Jack-of-all-trades-04/peruri-sentinel-chip/diagrams/diagram_1_arsitektur_sistem.png

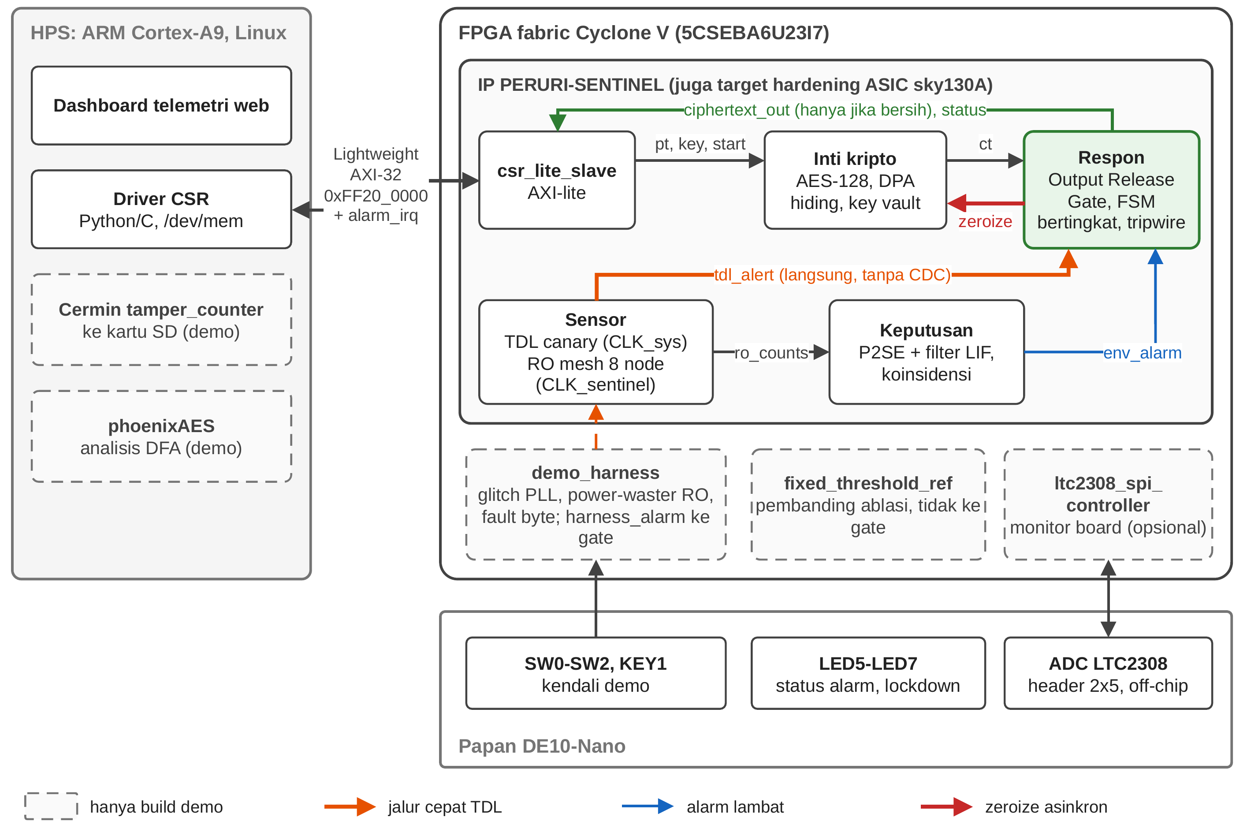
diagrams/diagram_1_arsitektur_sistem.png
