Jack-of-all-trades-04/peruri-sentinel-chip/diagrams/diagram_2_datapath_clock_domain.png

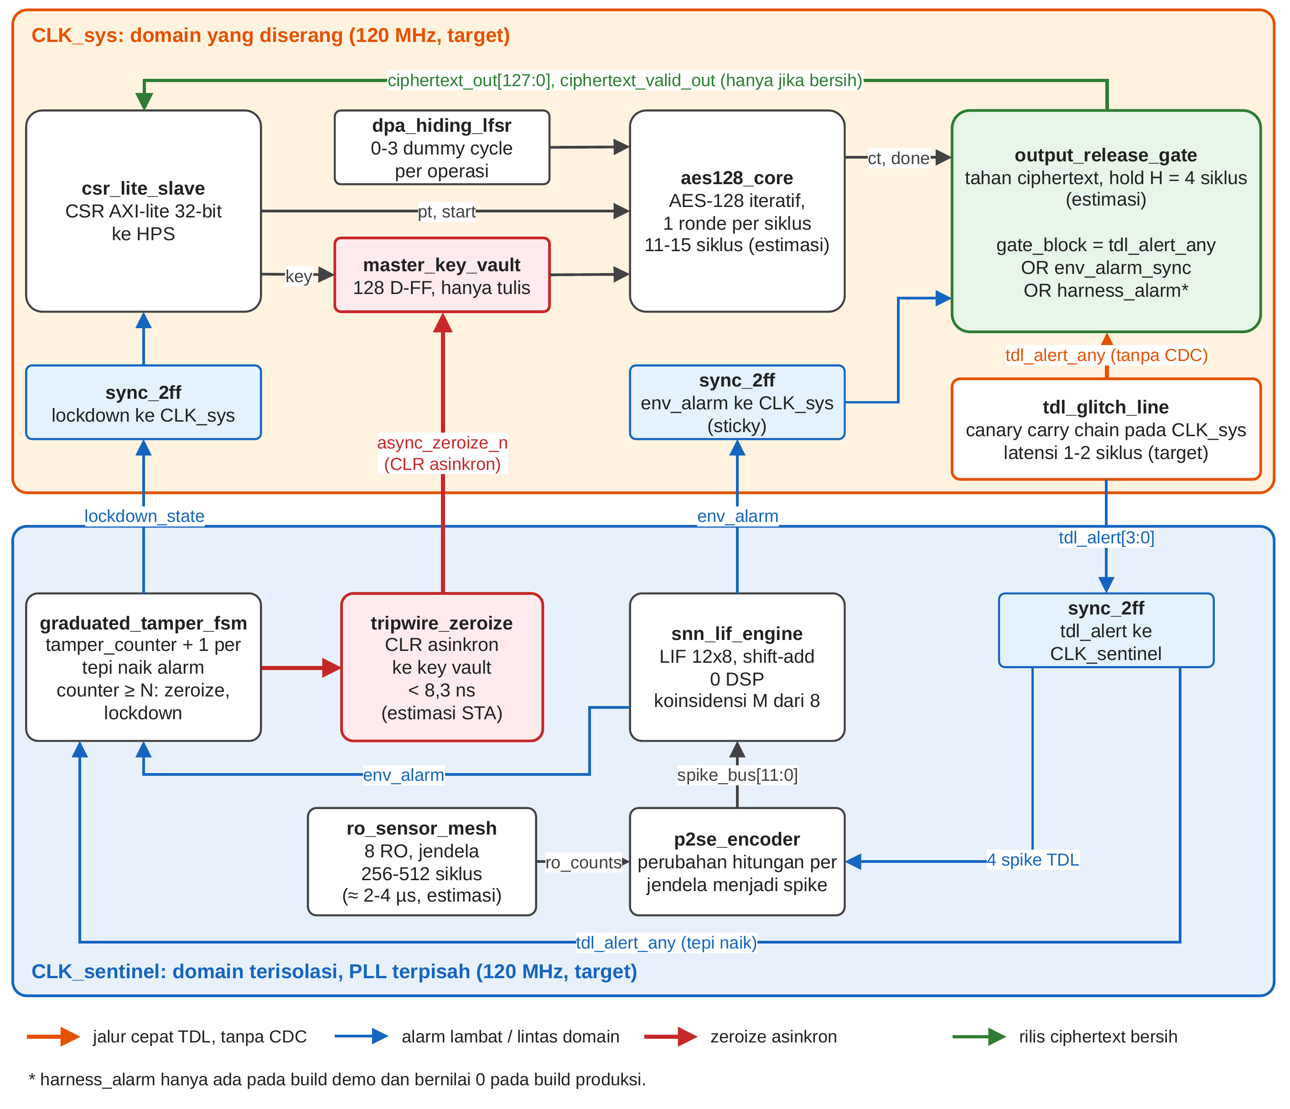
diagrams/diagram_2_datapath_clock_domain.png
