Jack-of-all-trades-04/peruri-sentinel-chip/diagrams/diagram_3_fsm_respon_bertingkat.png

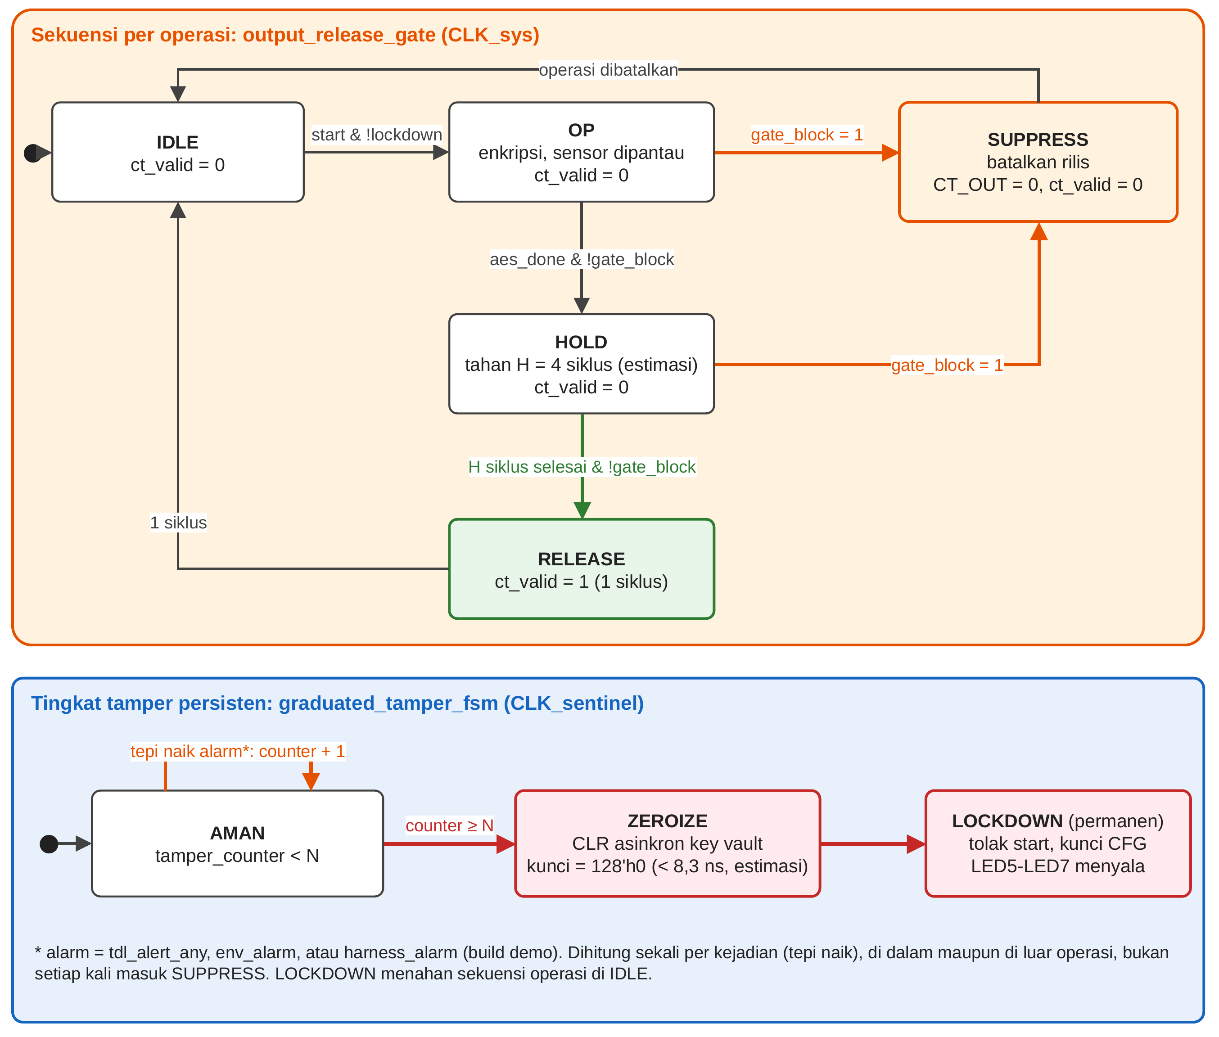
diagrams/diagram_3_fsm_respon_bertingkat.png
