Jack-of-all-trades-04/peruri-sentinel-chip/diagrams/diagram_4_timing_output_release_gate.png

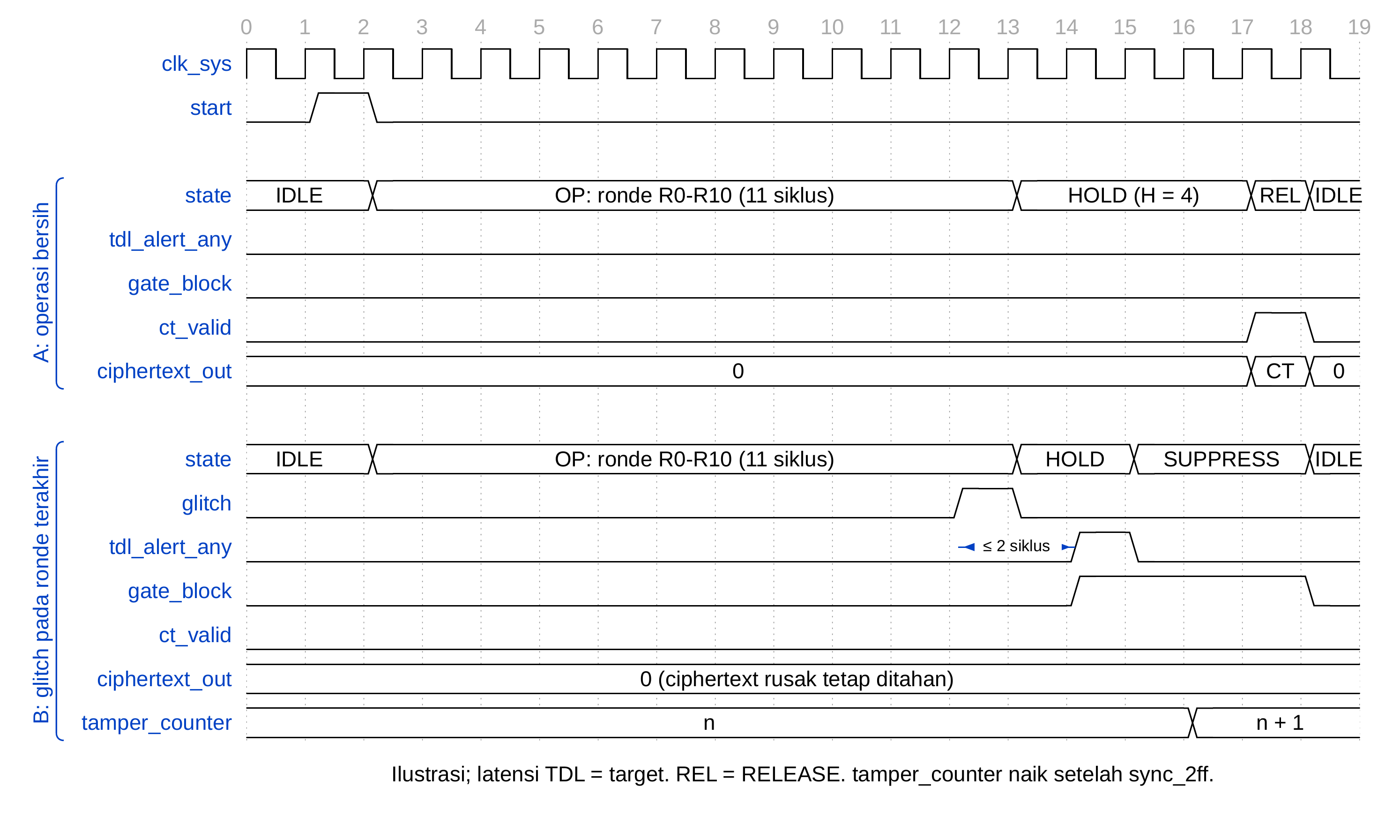
diagrams/diagram_4_timing_output_release_gate.png
