Jack-of-all-trades-04/peruri-sentinel-chip/diagrams/waveforms/T1_02_sentinel_off_ciphertext_salah_bocor.png

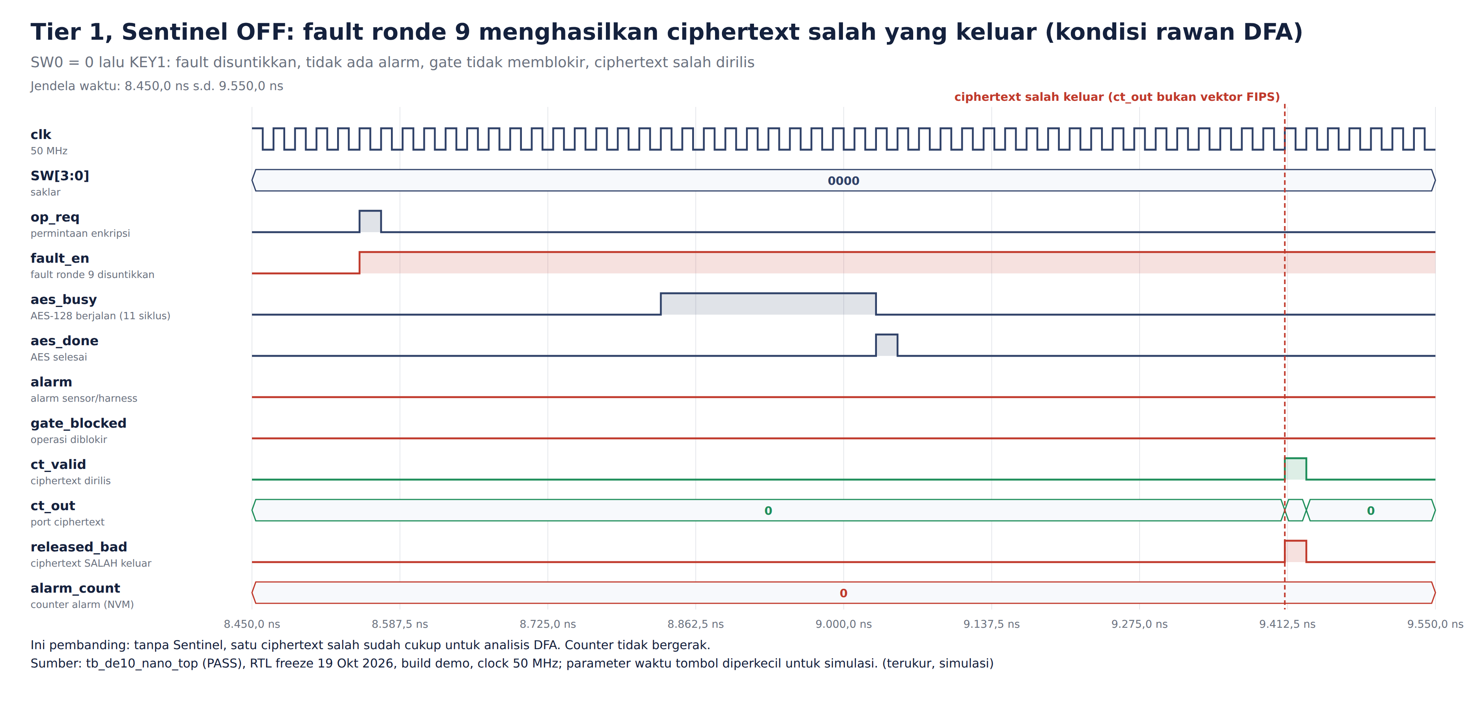
diagrams/waveforms/T1_02_sentinel_off_ciphertext_salah_bocor.png
