Jack-of-all-trades-04/peruri-sentinel-chip/diagrams/waveforms/T1_03_sentinel_on_serangan_diblokir.png

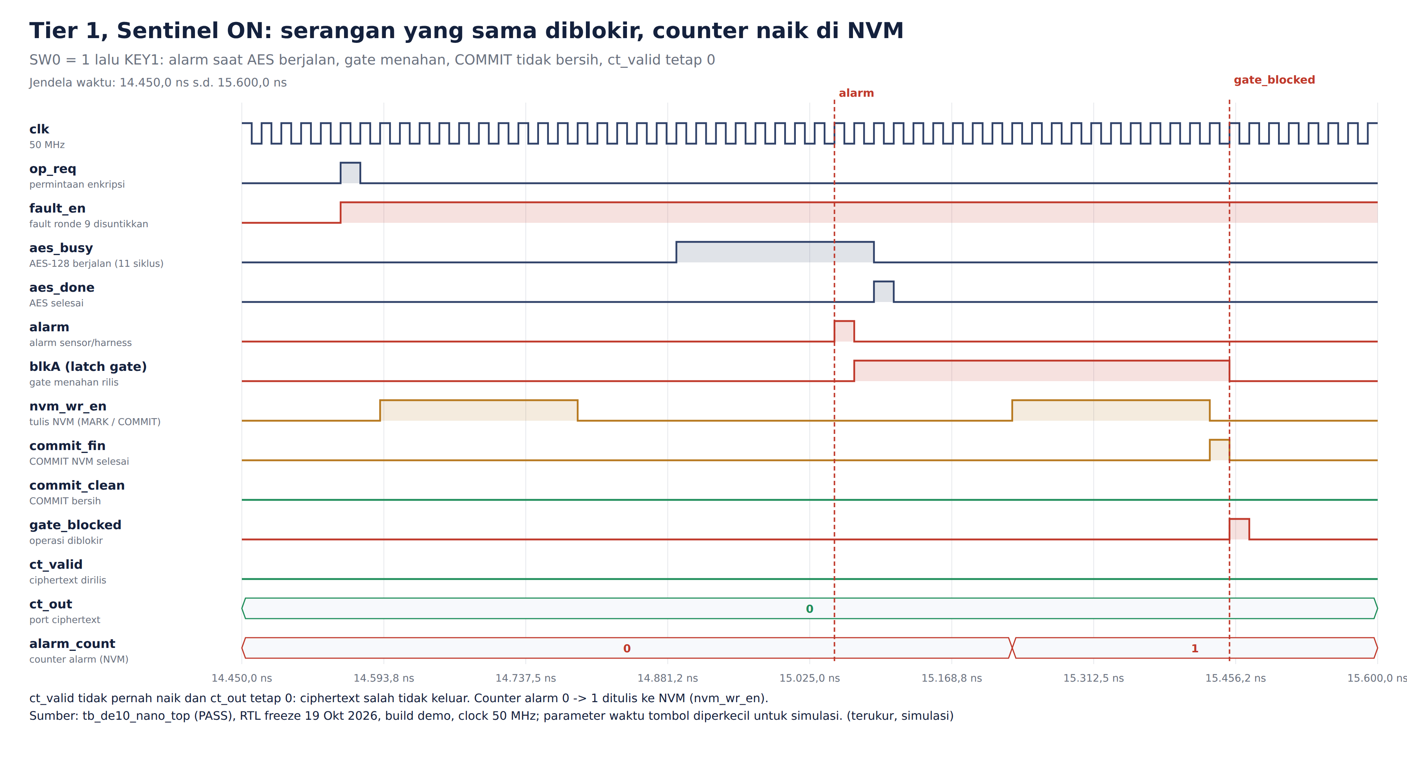
diagrams/waveforms/T1_03_sentinel_on_serangan_diblokir.png
