Jack-of-all-trades-04/peruri-sentinel-chip/diagrams/waveforms/T1_04_serangan_ke4_lockdown_zeroize.png

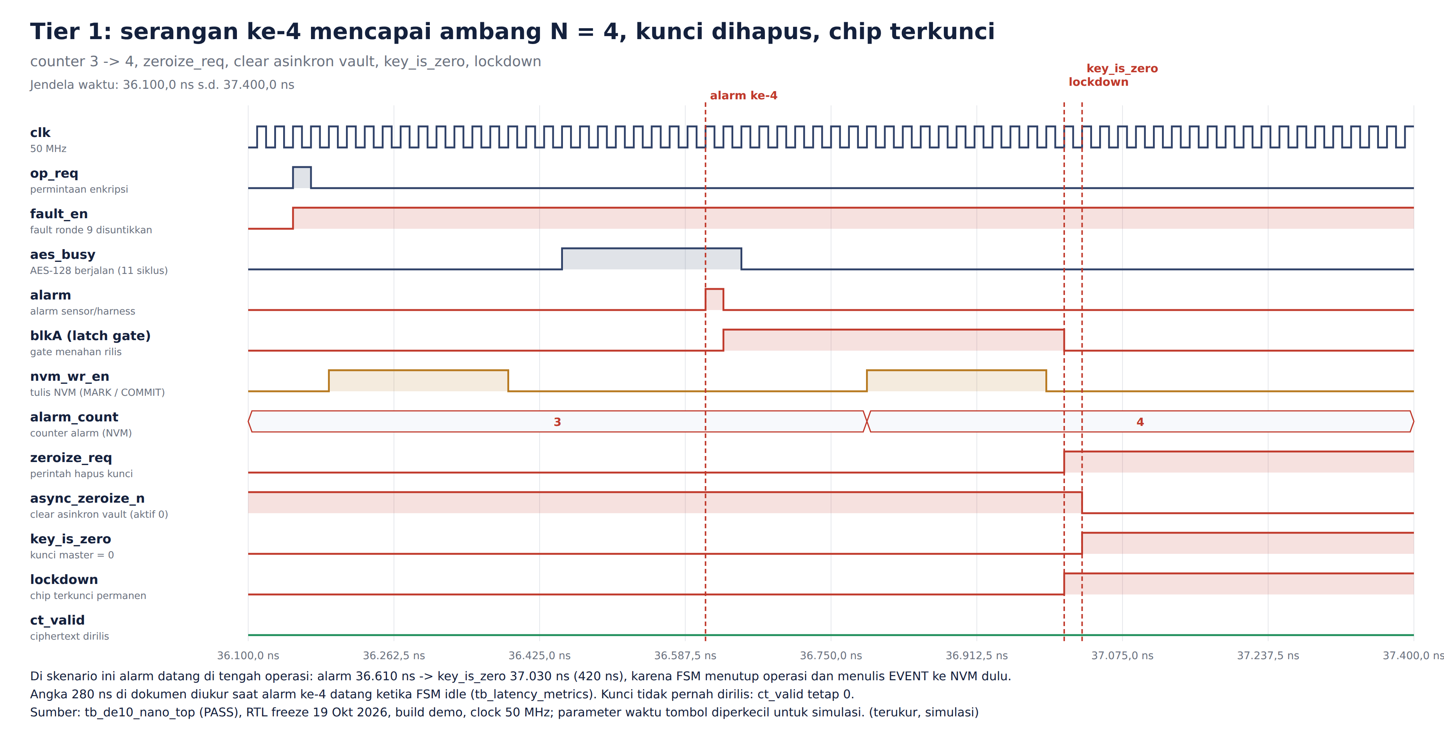
diagrams/waveforms/T1_04_serangan_ke4_lockdown_zeroize.png
