Jack-of-all-trades-04/peruri-sentinel-chip/diagrams/waveforms/T1_06_kartu_dicabut_counter_bertahan.png

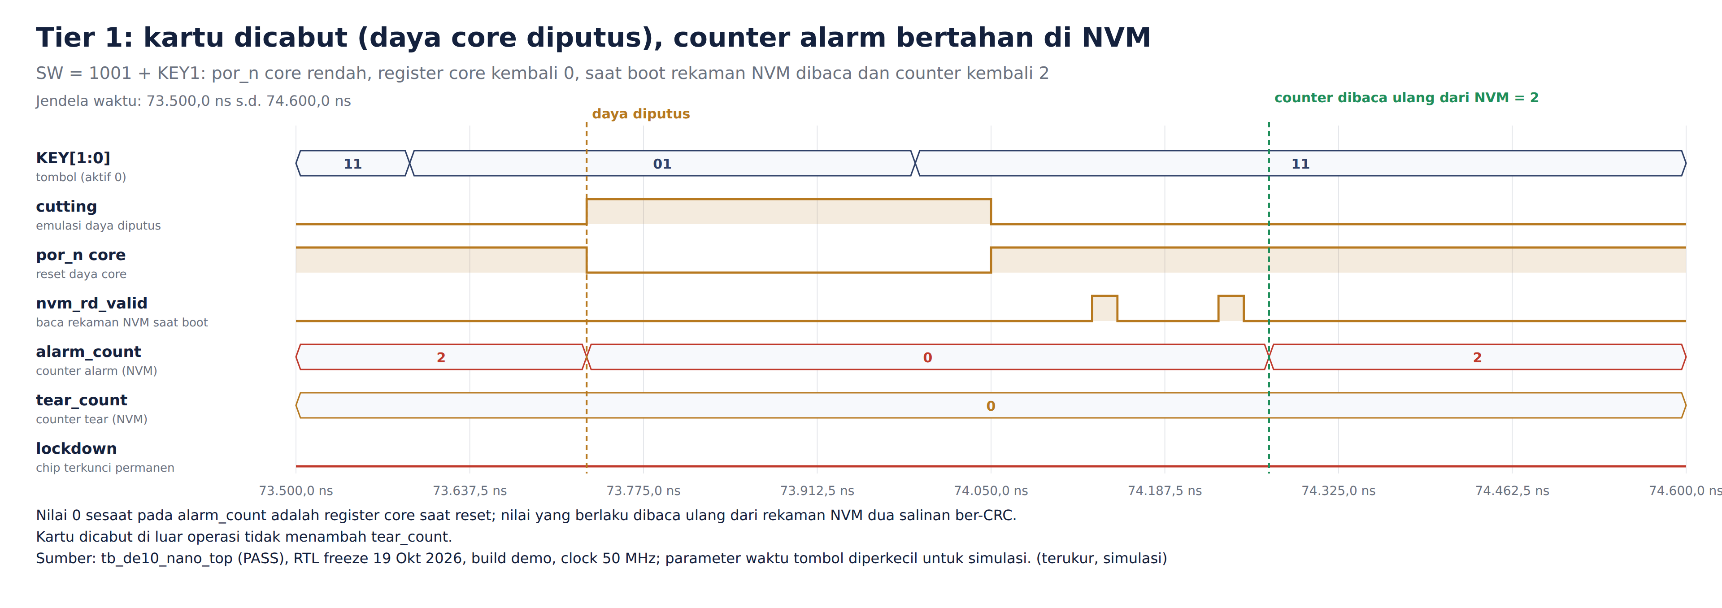
diagrams/waveforms/T1_06_kartu_dicabut_counter_bertahan.png
