Jack-of-all-trades-04/peruri-sentinel-chip/diagrams/waveforms/T1_07_power_cut_di_tengah_operasi.png

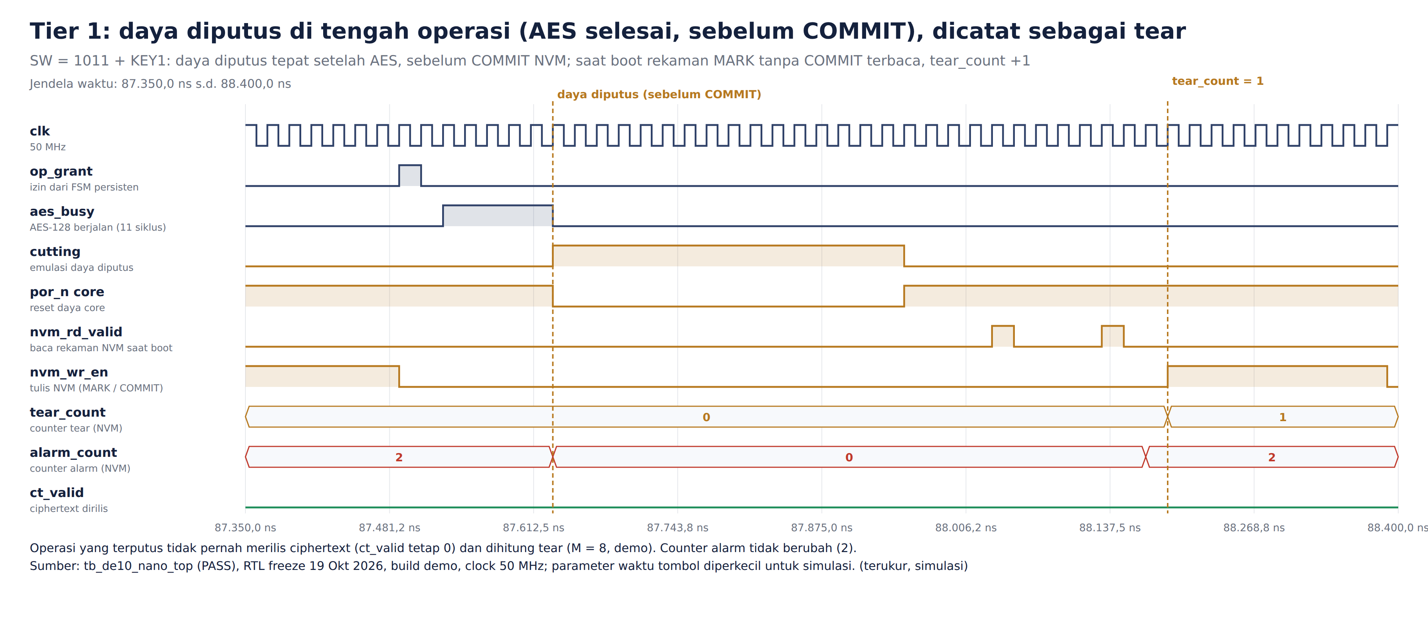
diagrams/waveforms/T1_07_power_cut_di_tengah_operasi.png
