Jack-of-all-trades-04/peruri-sentinel-chip/diagrams/waveforms/T2_00_ikhtisar_seluruh_skenario.png

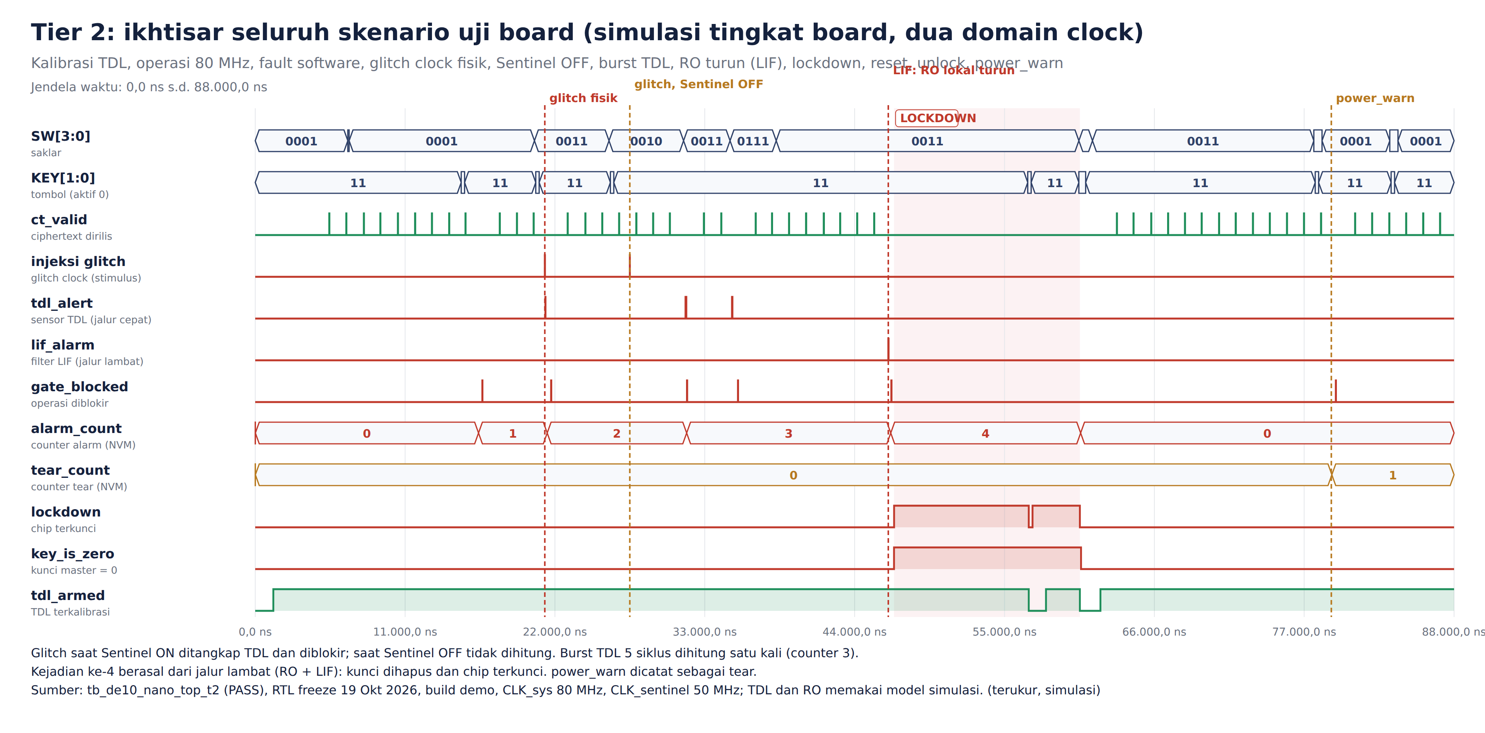
diagrams/waveforms/T2_00_ikhtisar_seluruh_skenario.png
