Jack-of-all-trades-04/peruri-sentinel-chip/diagrams/waveforms/T2_02_glitch_clock_ditangkap_tdl.png

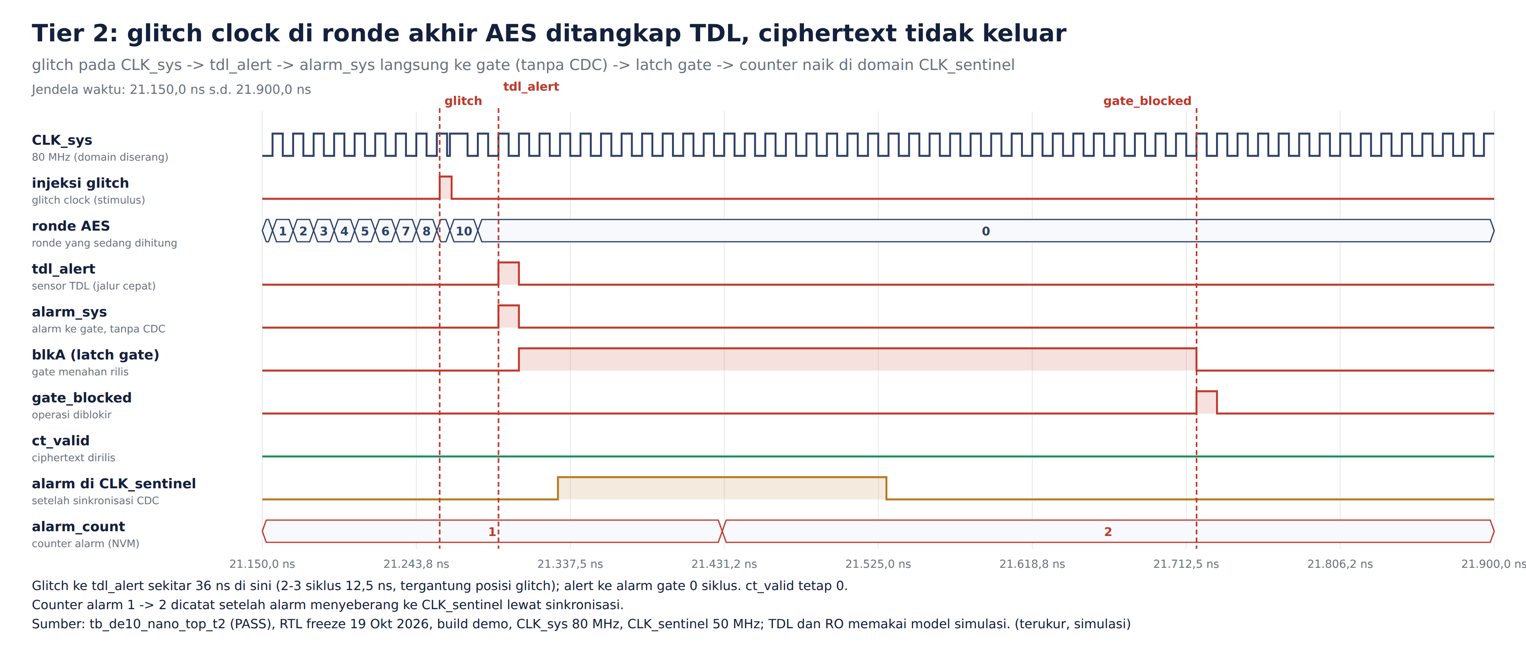
diagrams/waveforms/T2_02_glitch_clock_ditangkap_tdl.png
