Jack-of-all-trades-04/peruri-sentinel-chip/diagrams/waveforms/T2_03_jalur_lambat_lif_lockdown.png

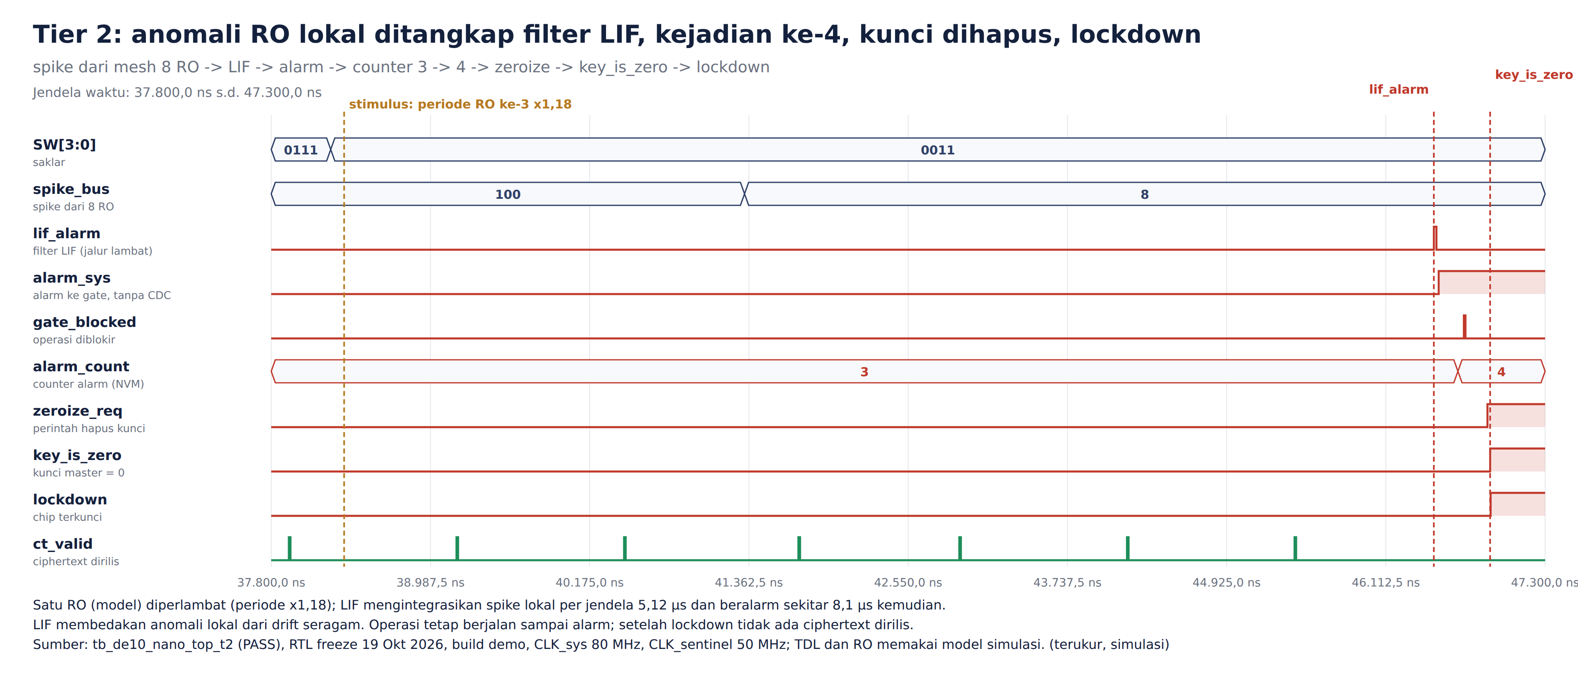
diagrams/waveforms/T2_03_jalur_lambat_lif_lockdown.png
