Jack-of-all-trades-04/peruri-sentinel-chip/diagrams/waveforms/T2_07_clk_sys_dihentikan_di_tengah_operasi.png

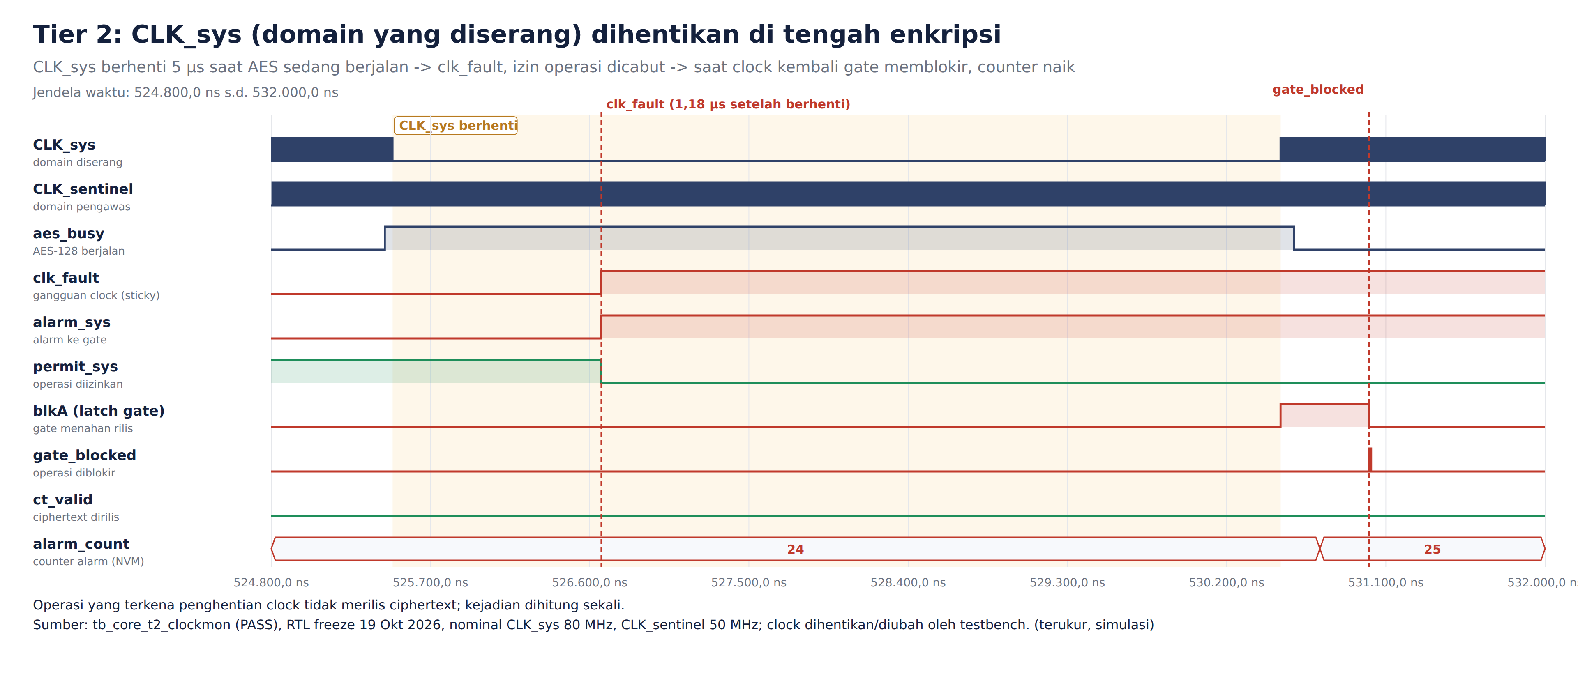
diagrams/waveforms/T2_07_clk_sys_dihentikan_di_tengah_operasi.png
