Jack-of-all-trades-04/peruri-sentinel-chip/(commit log)

2026-10-17 Tier 2 RTL: TDL canary, RO mesh, LIF filter, glitch injector, two clock domains
2026-10-17 Sim waveforms, LF line endings, Quartus LED drive settings
    - Testbenches dump sim_build/<tb>.vcd (skip with -DNO_DUMP); run_sim.sh points to them
    - .gitattributes keeps LF so run_sim.sh and Verilog work from Windows and Linux
    - qsf: keep Quartus 25.1 additions, set LED drive strength/slew, use all CPU cores
    - TESTS.md: how to open the waveforms
    Verified: 4/4 testbenches PASS (Icarus 12), syn/yosys_check.sh passes.
    Claude-Session: https://claude.ai/code/session_012GEWeFm4LR6agzkmmuawte
2026-10-17 Tier 2 waveforms, Indonesian TESTS.md, robust Yosys cell count
    - Tier 2 testbenches also dump sim_build/<tb>.vcd (skip with -DNO_DUMP)
    - sim/TESTS.md and sim/tier2/TESTS.md in Indonesian, with steps to
    generate the waveforms and where they are saved
    - yosys_check*.sh: cell count works with both old and new Yosys stat
    formats (Tier 2 script printed ALUT 0 / FF 0 before)
    Verified: Tier 1 4/4 PASS, Tier 2 4/4 PASS (Icarus 12), both Yosys checks pass.
    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
2026-10-19 RTL freeze 19 Okt: persistent tamper counter, dual-copy release gate, Tier 2 clock monitor, verification suite, sky130 flow
    - tamper_persist_fsm + nvm_counter_model (two-copy CRC record, MARK/COMMIT,
    alarm and tear counters survive power cycles) in Tier 1 and Tier 2
    - output_release_gate: single-fault tolerant dual-copy gate, two-stage
    registered release, dual-rail valid
    - Tier 2: CDC toggle handshake to the persistent FSM, clock_monitor and
    heartbeat_watch, power_warn abort; Quartus PLL IP and clock-monitor bounds
    - New testbenches (Tier 1 16, Tier 2 9 incl. production build), formal
    (SymbiYosys), coverage, gate-level fault/cosim, eqy, latency metrics
    - sky130 LibreLane flow (asic/)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
2026-10-19 README: RTL-freeze block diagram, measured waveform gallery, evidence and reproduction table, board results
